mcore1976/rp2040-parametric-directional-speaker/rp2040-directional-ultrasonic-speaker-microphone.png

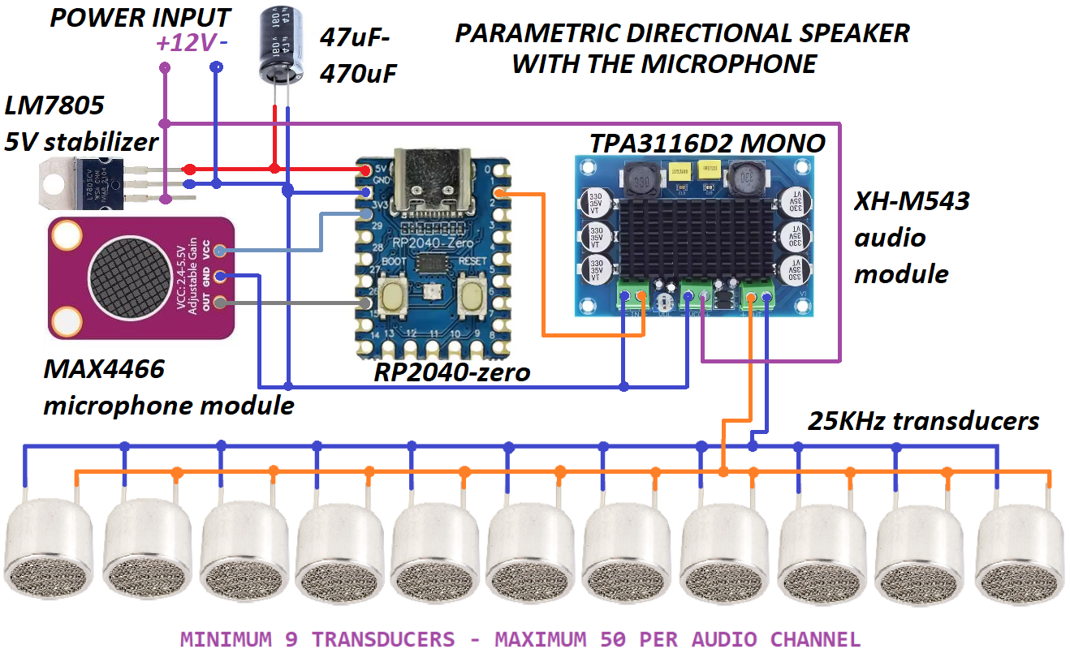
rp2040-directional-ultrasonic-speaker-microphone.png
