mcore1976/rp2040-parametric-directional-speaker/prototype-front.jpg

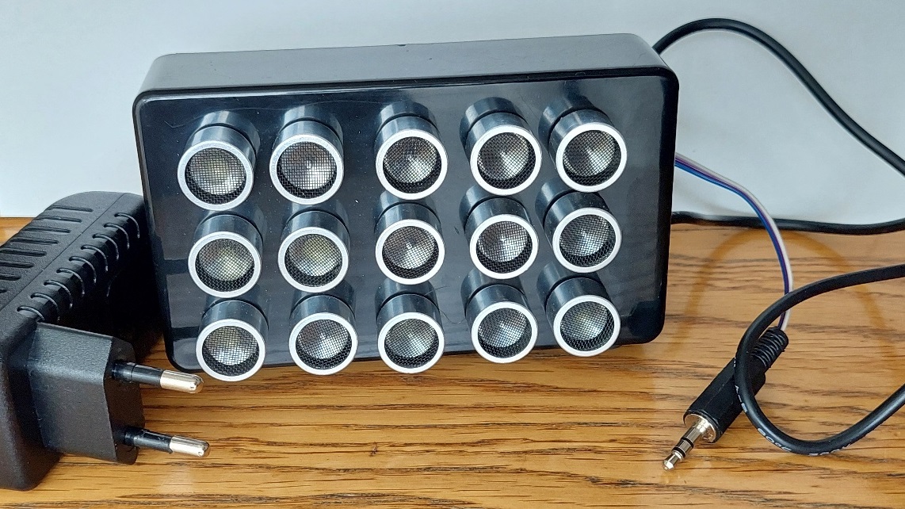
prototype-front.jpg
