mcore1976/rp2040-parametric-directional-speaker/prototype-inside-2.jpg

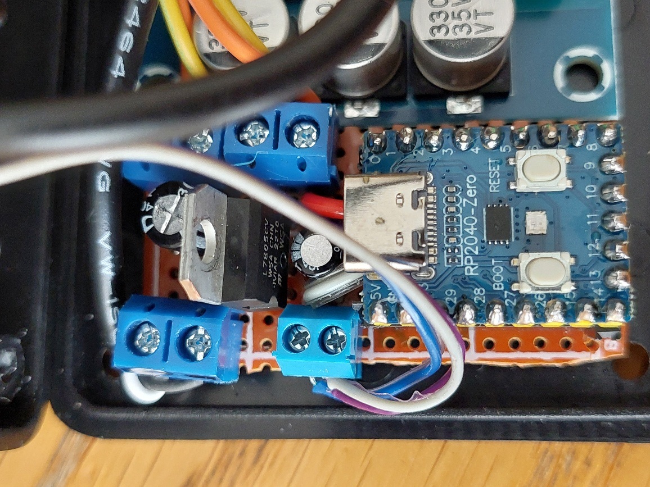
prototype-inside-2.jpg
