mcore1976/rp2040-parametric-directional-speaker/prototype-inside.jpg

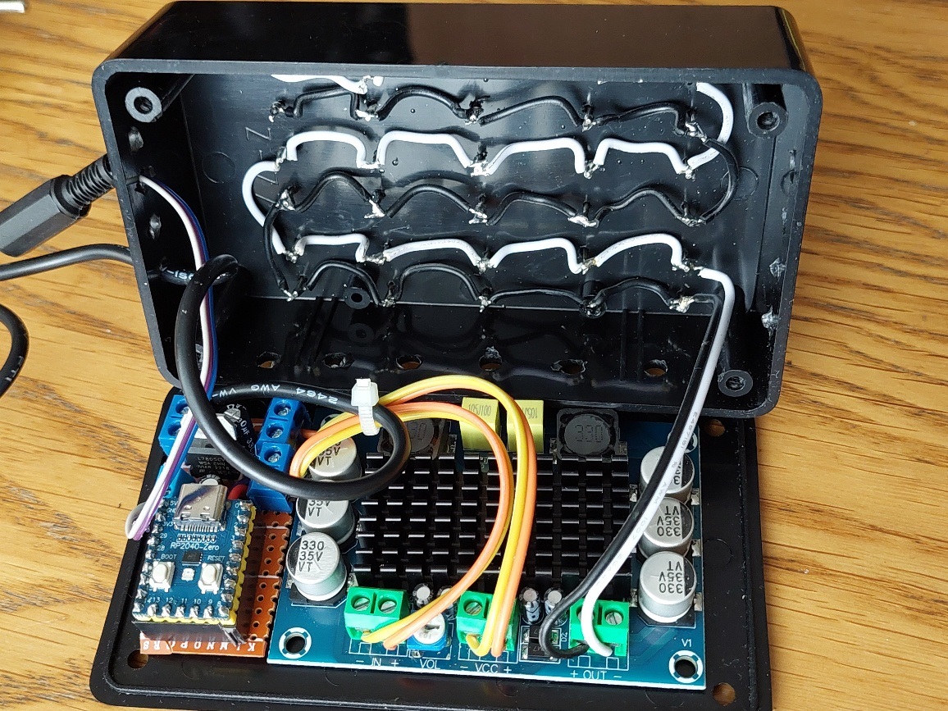
prototype-inside.jpg
